AqmarHaziq23/Comp-Arch-SouthpawOS/training/README.md

# Punch classifier training — Members A and C

Scripts that turn labelled raw windows (`R,...` lines in the session logs) into
a decision tree and export it to C for the wrist board. Raw captures go in
`training/data/raw/` (CSVs are committed; PNG plots are gitignored).
