AqmarHaziq23/Comp-Arch-SouthpawOS/(commit log)

2026-11-07 wrist: add P0 accelerometer logger and recording tools
    Add the P0 wrist pipeline: a TinyScreen+ with the Accelerometer TinyShield
    streams board_ms,x,y,z over USB at 200 Hz and +/-16 g, and Python tools save
    and plot labelled CSVs.
    - firmware/wrist/wrist_logger: fixed-rate sampling sketch. Checks dtr() instead
    of !SerialUSB, because the core's bool operator runs delay(10) on every call
    and capped the stream at about 81 Hz.
    - training/tools: log_accel.py and plot_accel.py, with credit headers.
    - firmware/wrist/README.md: full setup and recording steps.
    - docs/CITATIONS.md: credit the TinyCircuits example and BMA250 library.
    - .gitignore, training/README.md: commit CSVs in training/data/ra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
    [log_accel.py, plot_accel.py, wrist_logger.ino]
2026-11-09 wrist: add southpaw_wrist game firmware, BLE listener and punch segmenter
    P1 part 1 for the wrist boards: everything that doesn't need real punch data.
    - firmware/wrist/southpaw_wrist: non-blocking 200 Hz sampler (+/-16 g, ring
    buffer), threshold + peak search + cooldown detector, integer-only features,
    classifier stub (returns UNKNOWN), status screen, battery reading, and BLE
    over the ST shield (Nordic UART) advertising as P1D-WRIST-L/R from HAND in
    config.h. Sends P,<hand>,<type>,<peak_ms>,<peak_g> and answers T clock pings.
    COOLDOWN_MS is 400 (300 double-counted a punch's retract burst) and bursts
    under MIN_BURST_MS (20 ms) are ignored as knocks.
    - USB lines are sent with one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
    [battery.cpp, battery.h, ble.cpp, ble.h, ble_listen.py, classifier.cpp, classifier.h, config.h]
2026-11-10 wrist: count BLE as connected only once notifications are on
    The shake test showed punches over BLE arrive (24/26), but the first two
    were lost: the board treated the link as connected as soon as it came up,
    while the laptop was still discovering services and hadn't switched on
    notifications yet. The board now watches the notify characteristic's CCCD
    and only sends (and shows BLE: connected) once notifications are on. Punches
    in the gap are logged as not sent instead of silently lost, and the USB log
    prints each BLE state change.
    Tested on hardware: state goes link-up-notify-off -> connected, 3/3 punches
    sent after that arrived, T pings still answered, sampling stays at 5 ms gaps.
2026-11-10 hub: ignore NUL bytes from the STBLE UART example
    The TinyCircuits UARTPassThrough sketch sends the string terminator after each message, which broke parsing of every message after the first.
2026-11-10 protocol: move heart rate to its own station (v1.2)
    The pulse sensor is on a separate board now, so H messages come from 'hr' instead of the bag.
2026-11-10 sim: send heart rate from the hr station
    Also adds the hr board to boards.example.toml.
2026-11-10 docs: update readmes after the first BLE test
    Bag no longer has the pulse sensor, add an hr_station readme, and write down what we learned getting the laptop to talk to a board.
2026-11-11 protocol v1.3: add X for unknown punches
    The wrist board can detect punches before it can classify them, so it needs a way to say so. Also writes down what board_ms and peak_g mean and the wrist's send delay.
2026-11-11 fusion: wait for late wrist messages, use camera type for X
    Punch messages arrive ~250-310 ms after the peak, so the hub now waits for them before resolving. The simulator adds the same delay.
2026-11-11 boards.example: boards are matched by address
2026-11-11 wrist: search 150 ms for the peak; document offhand label
    PEAK_SEARCH_MS 100 -> 150. On real jabs a slow 3-4 g wind-up set off the
    trigger about 110 ms before the snap, so 100 ms took the wind-up as the
    peak on 8 of 20 jabs (wrong time, 4 g instead of ~15 g, wrong axis).
    150 ms finds the snap on all 30 jabs and all 31 crosses; the send delay
    is unchanged (still 250 ms after the peak).
    README: add the offhand label (board arm while the other hand punches),
    which set off the detector 12 times in 20 s on the right wrist.
    [config.h]
2026-11-11 training: first punch recordings (ym, both wrists)
    23 recordings from training/tools/log_accel.py, 200 Hz, +/-16 g, recorded
    2026-11-11 by Yue Ming (orthodox stance, shadowboxing). Board strapped to
    the back of the forearm in the same position on both arms; jab along -x.
    Left wrist (lead): jab x3 (30), hook x4 (26 + 9 soft), uppercut x3 (33),
    idle x2 (guard/bouncing; 5 sharp pull-backs, 2 trigger).
    Right wrist (rear): cross x3 (31), hook x3 (29), uppercut x3 (31),
    idle x1 (3 triggers from bouncing), offhand x1 (left hand punching
    while the board is on the right: 12 triggers).
    Notes for training:
    - ym_L_hook_20261111-083449: USB cable pulled out after ~11.6 s; 7 hooks.
    - ym_L_hook_202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
    [ym_L_hook_20261111-083449.csv, ym_L_hook_20261111-102718.csv, ym_L_hook_20261111-102932.csv, ym_L_hook_20261111-103233.csv, ym_L_idle_20261111-103900.csv, ym_L_idle_20261111-104229.csv, ym_L_jab_20261111-082932.csv, ym_L_jab_20261111-083113.csv]
2026-11-11 wrist: document how to mount the board for recordings
    Back of the wrist, screen out, USB port towards the elbow, the same on every person, since the classifier learns the axis directions. Plus how to tape the cable so hooks don't pull it out.
2026-11-11 protocol v1.4: heart rate comes from the bag board
    We only have three boards, so the pulse sensor goes on the bag board and there's no separate hr board.
2026-11-11 docs: bag board readme for Ying Song and ZH, drop hr_station
2026-11-11 wrist: add whole-window features for the classifier
    On hooks and uppercuts the detector takes the swing as the peak on some
    punches and the snap on others, so values measured at the peak sample
    (dominant axis, tilt) shift between punches of the same type. Add ten
    features that describe the whole 400 ms window instead:
    - max_x/y/z, min_x/y/z: largest and smallest value of each axis
    - order_x/y/z: ms from that axis's max to its min (> 0 = max first)
    - win_peak_counts: largest total acceleration in the window
    Same integer maths in features.cpp and segment_punches.py (ties go to
    the first sample). Checked on the board: 13/13 punches identical in all
    fields between the board's # punch lines and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
2026-11-11 Added merged buzzer code and tinycircuit screen code
    [bag.ino]
2026-11-11 training: add per-hand decision tree trainer with leave-one-file-out test
    train_classifier.py cuts every recording with segment_punches.py (the
    board's own integers) and trains one tree per hand: left J/H/U/N, right
    C/H/U/N, where N = not a punch (idle and offhand files). Each file is
    predicted by a tree that never saw it. Prints recall/precision per type,
    a confusion table, per-person accuracy and the features used.
    First results (depth 3, one person, one session): left 90/100, right
    92/106 on unseen files. Most misses are not-a-punch (only 17 examples;
    holding out the offhand file leaves 3) and hook vs uppercut.
    --features window drops the gravity (arm angle) values, which the left
    tree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
2026-11-11 wrist: run the exported decision tree on the board
    train_classifier.py --export trains both per-hand trees on all
    recordings (depth 3, all features) and writes them with m2cgen into
    classifier_model.c (plain C: m2cgen's compound literals aren't valid
    C++) and classifier_model.h, which also builds the input array from
    PunchFeatures in training order. classifier.cpp picks this hand's tree
    and the first largest output, as scikit-learn does.
    New PUNCH_NONE ("not a punch"): counted in the stats line as
    not_punch=, printed on USB as type=N, not sent over BLE and not shown on
    the screen. Real punches now go out as J/C/H/U, which the hub accepts,
    so the board no longer sends X.
    Checks: m2cgen's tr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
    [classifier.cpp, classifier.h, southpaw_wrist.ino, train_classifier.py]
2026-11-11 wrist: random forest classifier, pull-back and strap recordings
    - 5 new left-wrist "not a punch" recordings: offhand x2, pullback x2
    (pull-backs, feints, guard resets) and strap (putting the board on).
    - train_classifier.py: new labels pullback/strap -> N. Default model is
    now a random forest (20 trees, depth 5); --trees 1 gives the old
    single tree. Export writes m2cgen's forest helpers once, as static.
    - Leave-one-file-out: a single depth-3 tree let 13/45 not-a-punch
    movements through on the left; the forest lets 2 through (L 126/143,
    R 99/106 vs 92/106 for the tree). Main remaining error: hooks called
    uppercuts.
    - Checked: m2cgen == sklearn on all 249 recorded punches; L board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
    [ym_L_offhand_20261111-144121.csv, ym_L_offhand_20261111-165627.csv, ym_L_pullback_20261111-165814.csv, ym_L_pullback_20261111-165924.csv, ym_L_strap_20261111-170038.csv]
2026-11-12 hub: the real game - card tap, 5 bag hits to start, rounds, upload
    python -m southpaw play boards.toml (or --sim). Rounds go to the website through Jovis's pi_uploader and to the local database. Punch type X counts if the hand is right, until the wrist classifier exists.
2026-11-12 bag + protocol v1.5: start screen (M,WAIT) and the game flow
2026-11-12 bag: auto-calibrate in hub mode, print near misses
    Outside rounds the bag keeps measuring its own wobble and sets the hit threshold like the standalone calibration does (1 g minimum, 2 g maximum), so a swinging bag doesn't count as hits. Every 3 s it prints the threshold and the strongest movement that was too weak to count, to help tune PUNCH_MIN_G.
    [bag.ino]
2026-11-13 training: prepare for palm-side mounting, add record_set.py
    - The boards move to the palm side of the forearm (case and strap).
    The old back-of-wrist recordings don't transfer (1/9 palm-side hooks
    right, also after flipping y and z), so they move to
    training/data/raw/back_of_wrist/, which training doesn't read.
    - record_set.py: records a person's whole set for one wrist (3 files
    per punch type + offhand, pullback x2, strap, idle). Checks the
    mounting from gravity first, beeps for ready/go/stop, reports how
    many punches each file has, and can redo the last file.
    - log_accel.py: recording loop moved into record() so record_set.py
    can reuse it. Same command-line behaviour.
    - train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
    [ym_L_hook_20261111-083449.csv, ym_L_hook_20261111-102718.csv, ym_L_hook_20261111-102932.csv, ym_L_hook_20261111-103233.csv, ym_L_idle_20261111-103900.csv, ym_L_idle_20261111-104229.csv, ym_L_jab_20261111-082932.csv, ym_L_jab_20261111-083113.csv]
2026-11-13 ble: advertise the fixed address on all three boards
    The boards were advertising the chip's random address, which changed
    after the bag was reflashed. Use the BLE_PUBLIC_ADDR each sketch already
    sets: bag ...:42, left wrist ...:4C, right wrist ...:52.
    [ble.cpp]
2026-11-13 docs: fixed board addresses in boards.example.toml and the protocol
2026-11-14 Vision: track whether the boxer keeps their guard up (replaces punch detection)
    - guard.py: per frame, each fist must be no lower than ~the bottom of the chin
    (0.25 body lengths below the mouth) and near the face; a hand down >= 0.4 s is a drop;
    GuardTracker adds up guard % and drops (with an "ignore" input for punch moments)
    - vision_main.py: webcam -> MediaPipe Pose -> guard check -> hub (UDP 5005,
    {"kind":"guard","L":..,"R":..} ~9x/s + heartbeat); overlay with HANDS UP!,
    --record-raw / replay for tuning, H.264 overlay videos, checks/s counter
    - thresholds tuned on 3 recorded sessions; test_guard.py (14 tests)
    - reused from the vision branch: camera.py, run_vision.sh, requirements,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
2026-11-14 Wrist: retrain both hands for the palm-side case
    - 29 new recordings in the wrist case (Yue Ming): right 14 files (cross, hook,
    uppercut x3 each, offhand, pullback x2, strap, idle), left 15 (jab, hook,
    uppercut x3 each, offhand x2, pullback x2, strap, idle).
    - The case turns the board 90 degrees flat on the arm: y now runs along the
    forearm. The left case sits turned 180 degrees from the right so the wearer
    can read the screen, so record_set.py's mount check now expects per hand:
    forearm up -> y -1 (R) / +1 (L), palm up -> z -1 on both.
    - Retrained random forests (20 trees, depth 5), leave-one-file-out:
    left 129/137 (94%), not-a-punch blocked 43/47; right 96/110 (87%),
    not-a-pu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
    [ym_L_hook_20261114-180731.csv, ym_L_hook_20261114-180808.csv, ym_L_hook_20261114-180842.csv, ym_L_idle_20261114-181338.csv, ym_L_jab_20261114-180548.csv, ym_L_jab_20261114-180625.csv, ym_L_jab_20261114-180657.csv, ym_L_offhand_20261114-181102.csv]
2026-11-14 Wrist: catch punches thrown in combos
    The hub test showed jab-cross-hook arriving as jab-cross: the left board
    missed the hook. In a combo the arm never drops below 3 g between the jab
    and the hook, and the detector only started a punch on a fresh rise past
    3 g, so a hook that began during the jab's cooldown was never counted
    (6 of 9 hooks missed in a recorded jab-cross-hook file).
    - Detector (detector.cpp and segment_punches.py, kept identical): after
    the cooldown, a punch starts whenever acceleration is above the
    threshold, not only on a rise past it.
    - COOLDOWN_MS 400 -> 350. Combo punches came 0.38-0.45 s apart; 300 also
    caught the pull-back ~0.3 s after an uppercut. Single-punch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
    [ym_L_combo-112_20261114-191150.csv, ym_L_combo-123_20261114-185610.csv, ym_L_combo-123_20261114-190209.csv, ym_L_combo-123_20261114-190927.csv, ym_L_combo-125_20261114-191010.csv, ym_L_combo-125_20261114-191111.csv, ym_L_combo-35_20261114-191234.csv, ym_L_combo-35_20261114-191422.csv]
2026-11-14 Wrist: right-wrist combo recordings and retrained right model
    - 6 right-wrist combo files: 2-4, 2-6 x2, 4-6 x2, 1-2-3-2. Every punch in
    every combo was detected with the new detector.
    - Right model, leave-one-file-out: 180/192 (94%, was 87%), combo punches
    79/82, single-punch files 101/110, not-a-punch blocked 17/19. The second
    2-6 and 4-6 files fixed rear hook vs rear uppercut in combos.
    - Left model unchanged (only the right model's summary comment moved).
    - Right board flashed; board vs Python on live punches and combos 26/26
    identical incl. type, 0 timing gaps.
    [ym_R_combo-1232_20261114-192200.csv, ym_R_combo-24_20261114-192035.csv, ym_R_combo-26_20261114-192120.csv, ym_R_combo-26_20261114-192345.csv, ym_R_combo-46_20261114-192240.csv, ym_R_combo-46_20261114-192428.csv]
2026-11-14 Wrist: stop the left board sending fake punches during right-hand combos
    Live hub test: when the right hand threw two punches in a row (2-6, 4-6),
    the left board sent a fake 11-14 g jab or uppercut in 6 of 9 combos. The
    body turn swings the left arm hard, and the left model had only seen
    offhand recordings with single right punches.
    - 2 left offhand files recorded while throwing right-hand combos only
    (36 triggers, up to 17 g), labelled not a punch.
    - Left model, leave-one-file-out: 268/279 (96%), not-a-punch blocked
    84/85 (all 36 new ones), combo punches 96/104. Right model unchanged.
    - Re-test on the hub: 0 fake left punches in 5 right-hand combos (was 2
    in 4), jab-cross-hook 4/4 wi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
    [ym_L_offhand_20261114-193538.csv, ym_L_offhand_20261114-193620.csv]
